hupop444/trace-memory-pebble-hackathon/TRACE-morphology-index-20260829.md

# TRACE Morphology Exploration - 2026-08-29

本轮目标不是继续给普通团子换轮廓，而是寻找一个能同时表达“触碰、留下、稍后讲述”的 TRACE 母形。所有方案均按两种尺寸考虑：包挂约 86 x 66 x 34 mm（普通 ESP32-S3），工牌约 74 x 46 x 21 mm（S3 Mini）。

## 评分标准

- 记忆点：远看轮廓和近看细节是否都能被记住。
- TRACE 契合：按压动作是否与造型变化、灯光反馈和“留下痕迹”形成同一个叙事。
- 半天制作：现有海绵 + 短毛绒包覆 + 小型硬托盘能否完成。
- 可佩戴：是否抗勾挂、不过度晃动、正反侧面都成立。
- 系列扩展：普通板和 Mini 板能否保持同一性格而不是简单缩放。

| 编号 | 方向 | 记忆点 | TRACE 契合 | 半天制作 | 可佩戴 | 系列扩展 | 总分 | 判断 |
|---|---|---:|---:|---:|---:|---:|---:|---|
| A | After-Squeeze Peanut | 3 | 4 | 5 | 4 | 5 | 21 | 结构可靠，但仍偏普通花生 |
| B | Broken Arch | 5 | 4 | 4 | 4 | 4 | 21 | 藏脸有趣，拱形仍需避免常见联想 |
| C | Pocket Fold | 4 | 5 | 5 | 5 | 5 | 24 | 互动清楚；后续需降低襁褓感 |
| D | Odd Stack | 3 | 3 | 5 | 4 | 5 | 20 | 易做，但仍像通用双层团子 |
| E | Kinked Comma | 5 | 4 | 5 | 5 | 5 | 24 | 年轻、利落、好佩戴，缺口可做按压区 |
| F | Loose Soft Knot | 5 | 5 | 2 | 3 | 3 | 18 | 雕塑感强，但裁片、内托和量产风险高 |
| G | Offset Split Seed | 4 | 5 | 4 | 4 | 5 | 22 | 互动优秀，但存在不必要的生物形态歧义 |
| H | TRACE Pucker | 5 | 5 | 5 | 5 | 5 | 25 | 最完整：缝线既是识别符号也是反馈通道 |
| I | Thumbprint Memory Dent | 5 | 5 | 5 | 5 | 5 | 25 | 最属于 TRACE：一次触碰直接成为形态记忆 |
| J | Soft Sidecar | 5 | 5 | 4 | 3 | 4 | 21 | 携带动作鲜明；桥位需做抗撕裂，颜色需降饱和 |
| K | Folded Soft Ribbon | 5 | 5 | 2 | 3 | 3 | 18 | 视觉强，但半天样机和藏板难度偏高 |
| L | Lazy Splash | 5 | 4 | 3 | 4 | 4 | 20 | 最活泼的风格外卡，可提取长弯瓣而不整套照搬 |

## 第一梯队

1. **I - Thumbprint Memory Dent**：建议作为 TRACE 的核心交互母题。按下去不是按一个按钮，而是把一个瞬间留在柔软表面。
2. **H - TRACE Pucker**：建议作为品牌视觉母题。斜向褶线可以跨包挂、工牌、腕带与桌面底座持续出现。
3. **E - Kinked Comma**：建议作为年轻活力的轮廓母题，解决 H/I 可能过于安静的问题。
4. **C - Pocket Fold**：建议保留“揭开/藏起”机制，但调整比例，避免像婴儿襁褓。
5. **L - Lazy Splash**：作为活力外卡，只提取一条长弯瓣和前折按压瓣。

## 下一轮组合原则

最有冠军潜力的方向不是直接选一张照做，而是：`I 的触碰凹痕 + H 的 TRACE 褶线 + E 的弯折轮廓`。组合时仍只保留一个主动作，避免三种特点堆在一起。

建议做三张最终收敛图：

1. `I + E`：弯折体内嵌拇指凹痕，最年轻、最直接。
2. `H + I`：褶线在凹痕处终止并亮起，最像完整品牌语言。
3. `E + L`：弯折缺口配一个长软瓣，最活泼、最适合包挂。
