hupop444/trace-memory-pebble-hackathon/electronics/TRACE_ESP32S3_SensorHub/renders/TRACE_ESP32S3_SensorHub_Schematic.png

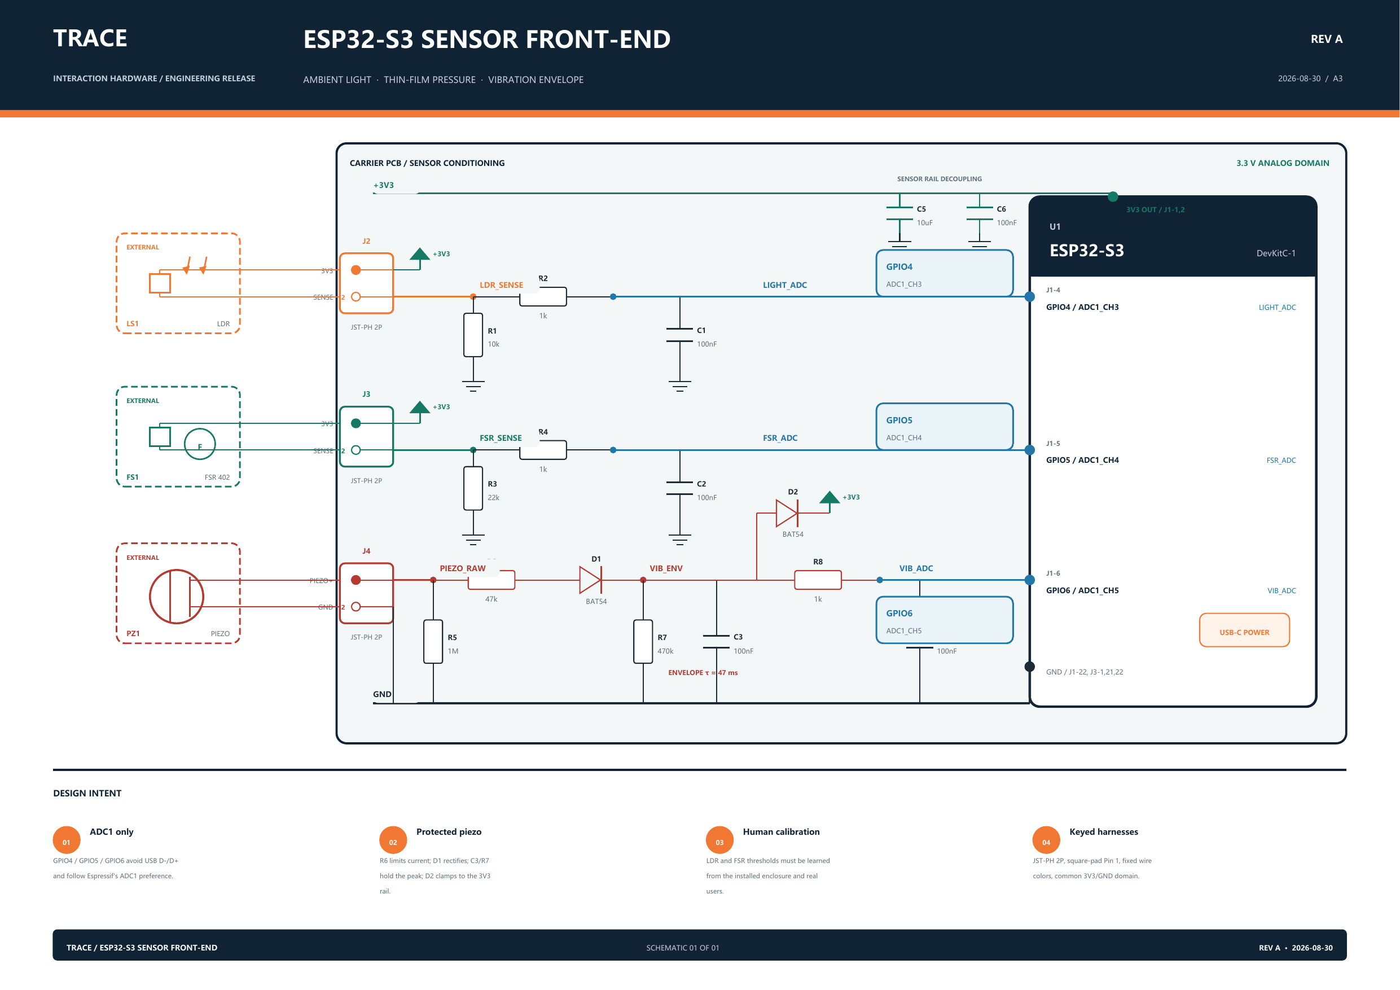
electronics/TRACE_ESP32S3_SensorHub/renders/TRACE_ESP32S3_SensorHub_Schematic.png
