hupop444/trace-memory-pebble-hackathon/exports/TRACE_bag_esp32_exploded.png

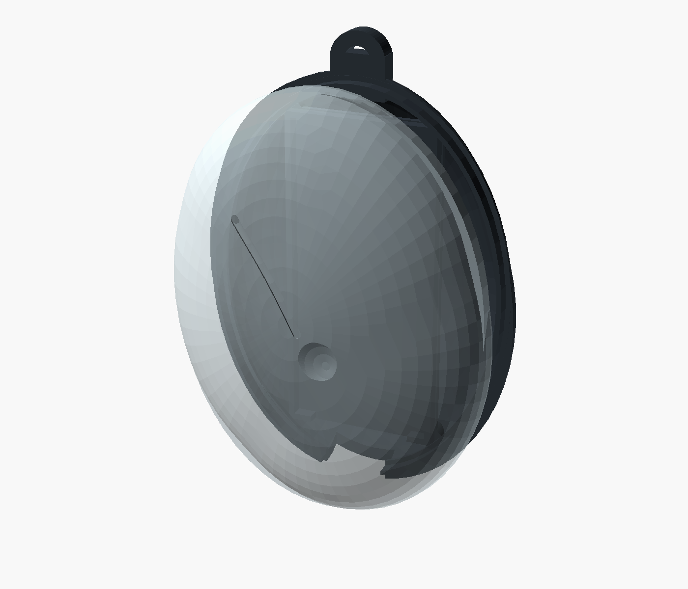
exports/TRACE_bag_esp32_exploded.png
