hupop444/trace-memory-pebble-hackathon/exports/TRACE_bag_esp32_preview.png

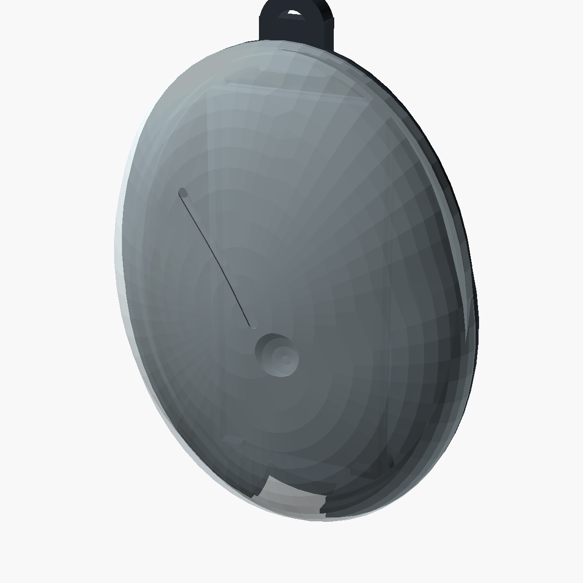
exports/TRACE_bag_esp32_preview.png
