hupop444/trace-memory-pebble-hackathon/exports/TRACE_bag_esp32_preview_locked.png

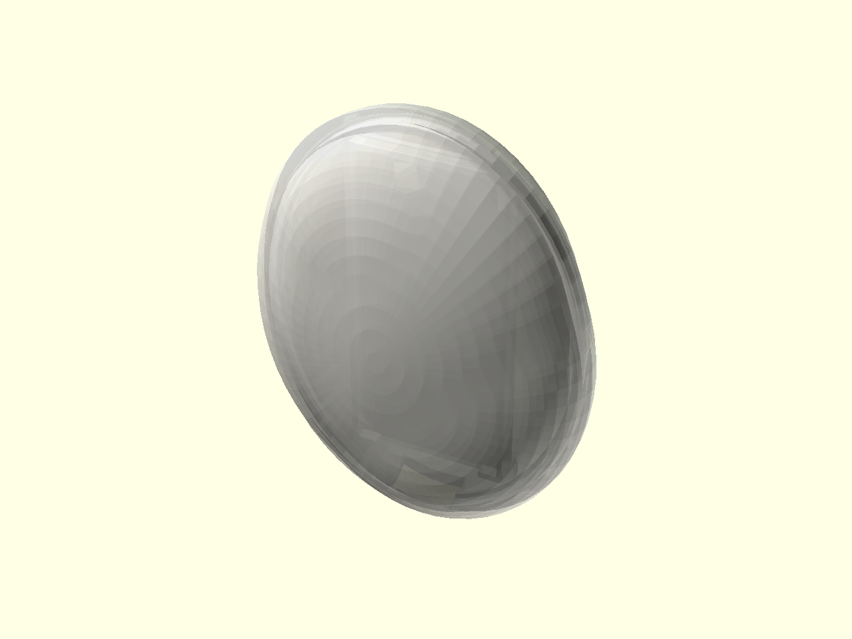
exports/TRACE_bag_esp32_preview_locked.png
