hupop444/trace-memory-pebble-hackathon/hardware/enclosure/output/trace_enclosure_preview.png

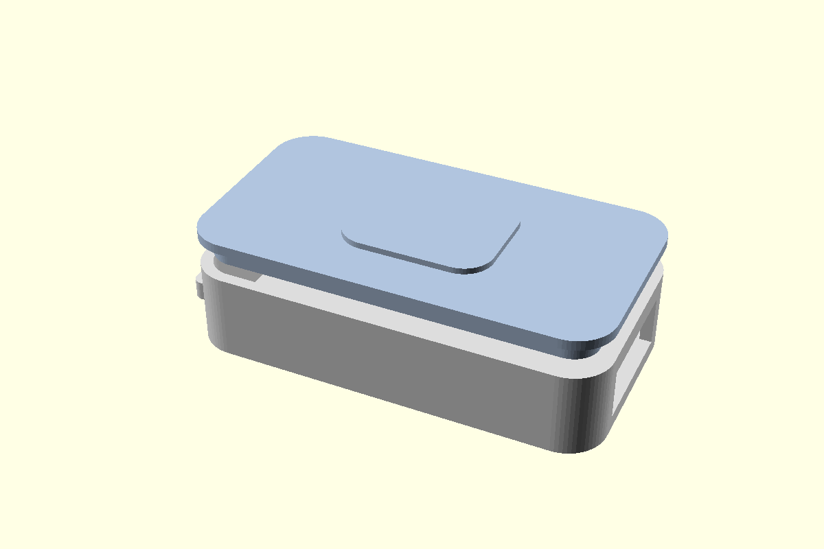
hardware/enclosure/output/trace_enclosure_preview.png
