hupop444/trace-memory-pebble-hackathon/renders/AIGC_campaign_20260829/TRACE_KV03_Family_16x9.png

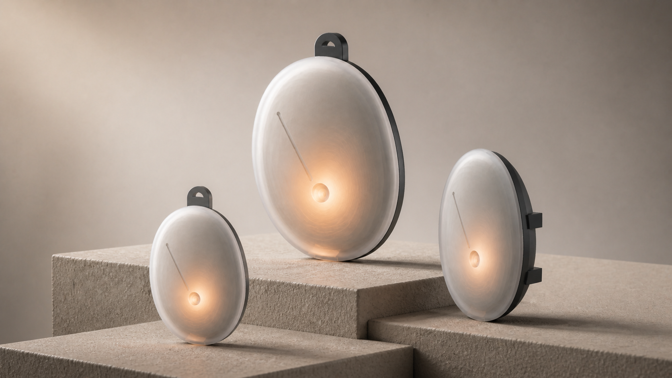
renders/AIGC_campaign_20260829/TRACE_KV03_Family_16x9.png
