hupop444/trace-memory-pebble-hackathon/renders/AIGC_campaign_20260829/TRACE_KV04_Garment_9x16.png

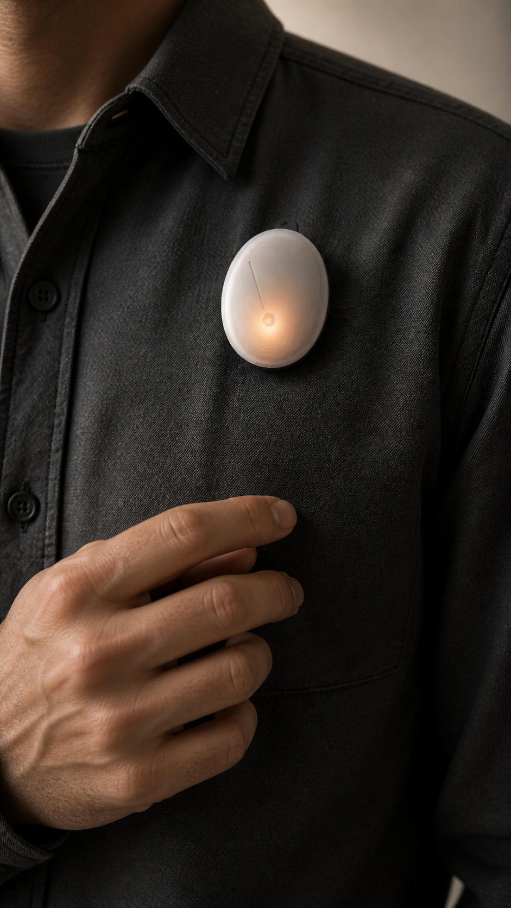
renders/AIGC_campaign_20260829/TRACE_KV04_Garment_9x16.png
