hupop444/trace-memory-pebble-hackathon/renders/AIGC_campaign_20260829/TRACE_KV05_Macro_239x1.png

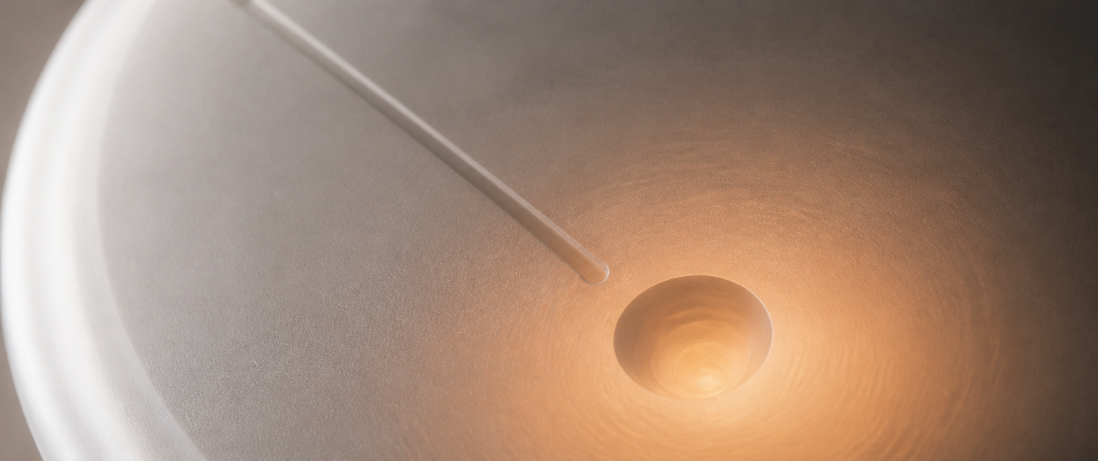
renders/AIGC_campaign_20260829/TRACE_KV05_Macro_239x1.png
