hupop444/trace-memory-pebble-hackathon/renders/AIGC_campaign_20260829_softshell_v2/TRACE_V2_KV02_SoftShell_HandPress_16x9.png

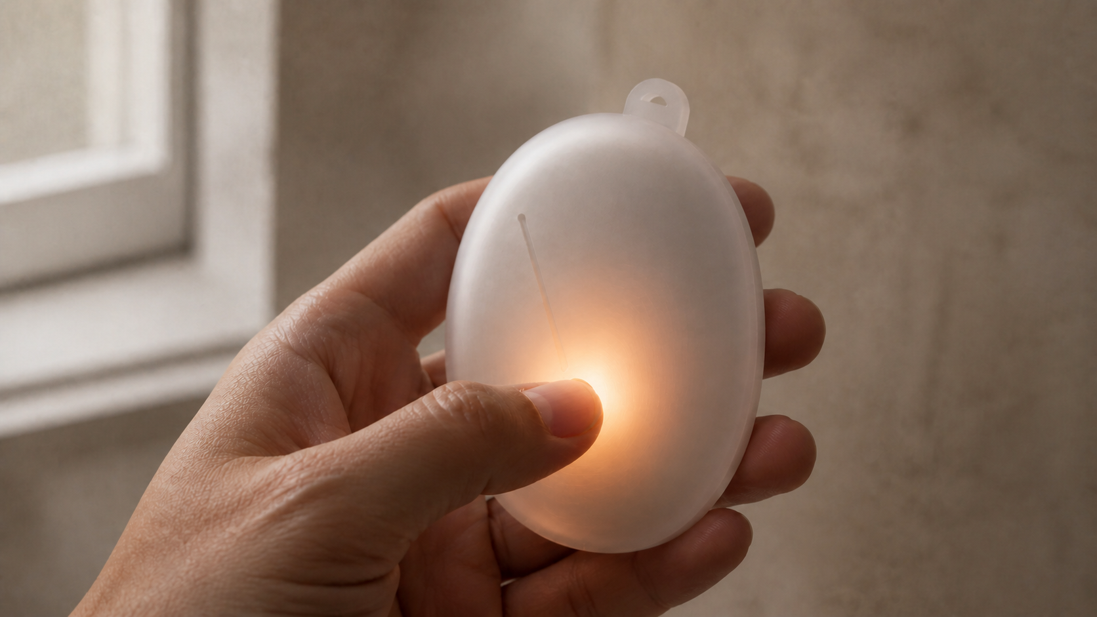
renders/AIGC_campaign_20260829_softshell_v2/TRACE_V2_KV02_SoftShell_HandPress_16x9.png
