hupop444/trace-memory-pebble-hackathon/renders/TRACE_film_locked_2.39_20260829/master_2048x858/TRACE_S03_BagCharm_239.png

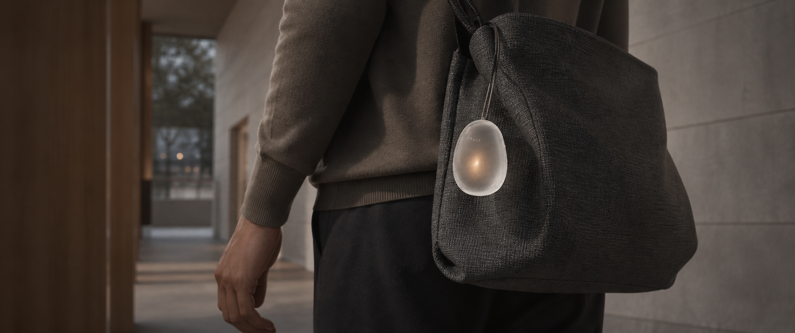
renders/TRACE_film_locked_2.39_20260829/master_2048x858/TRACE_S03_BagCharm_239.png
