hupop444/trace-memory-pebble-hackathon/renders/TRACE_film_locked_2.39_20260829/TRACE_8shot_contactsheet_2048x1716.png

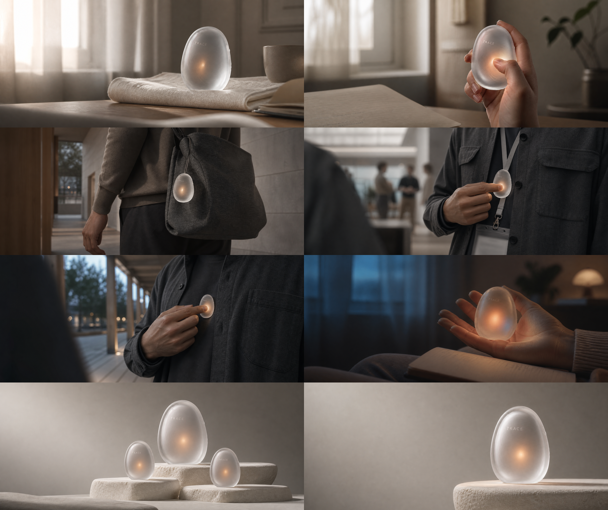
renders/TRACE_film_locked_2.39_20260829/TRACE_8shot_contactsheet_2048x1716.png
