hupop444/trace-memory-pebble-hackathon/exports/TRACE_clip_mini_front.stl

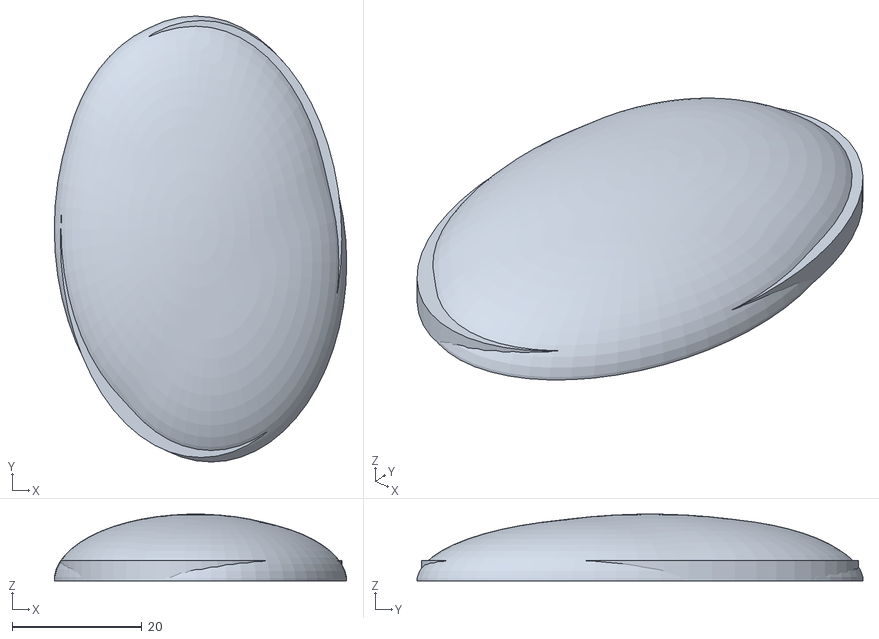
[picture p25: CAD file, 2026-08-29]
exports/TRACE_clip_mini_front.stl
45.1 x 68.8 x 10.3
