hupop444/trace-memory-pebble-hackathon/hardware/enclosure/output/trace_base.stl

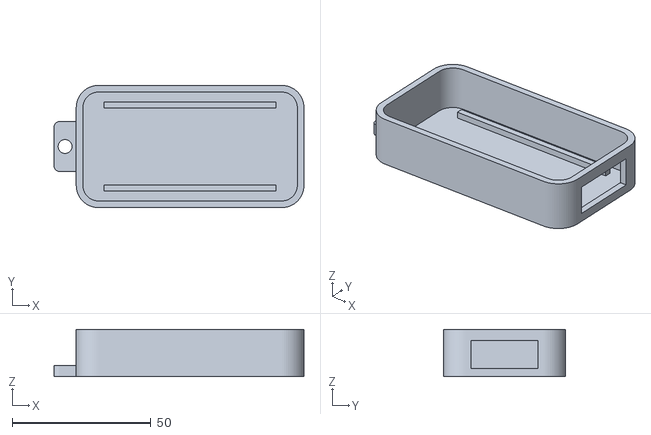
[picture p26: CAD file, 2026-08-29]
hardware/enclosure/output/trace_base.stl
90.0 x 44.0 x 17.0
