hupop444/trace-memory-pebble-hackathon/exports/TRACE_clip_mini_board.stl

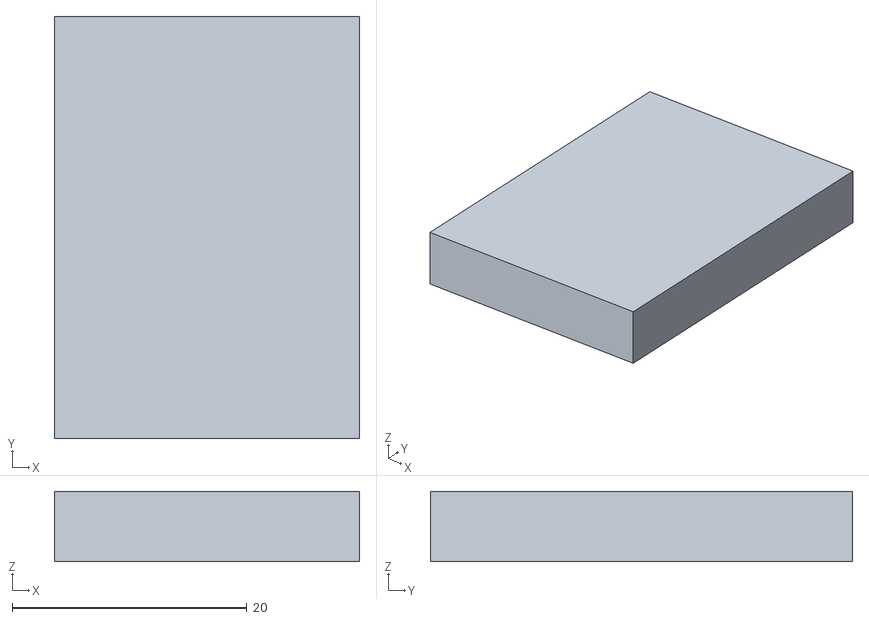
[picture p27: CAD file, 2026-08-29]
exports/TRACE_clip_mini_board.stl
26.0 x 36.0 x 6.00
