hupop444/trace-memory-pebble-hackathon/hardware/enclosure/output/trace_pressure_lid.stl

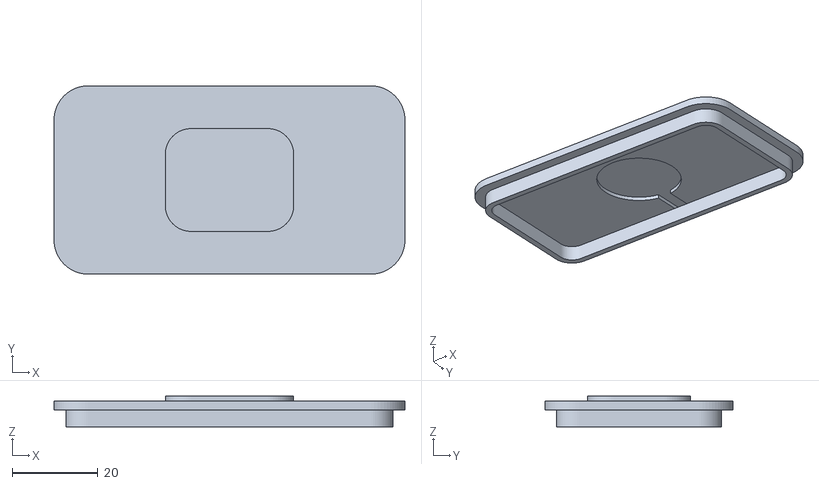
[picture p28: CAD file, 2026-08-29]
hardware/enclosure/output/trace_pressure_lid.stl
82.0 x 44.0 x 7.20
