hupop444/trace-memory-pebble-hackathon/exports/TRACE_bag_esp32_sensor.stl

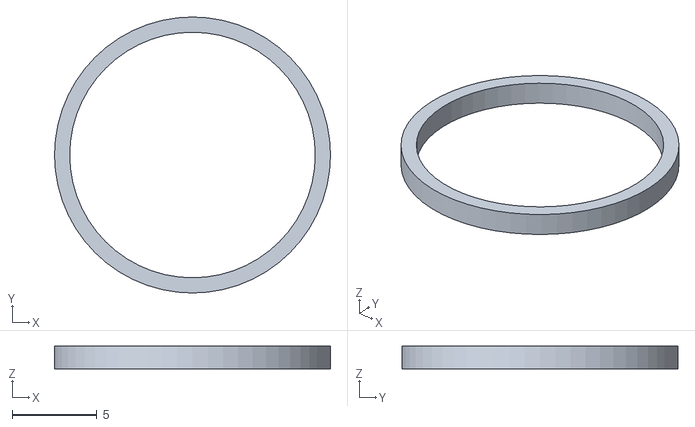
[picture p29: CAD file, 2026-08-29]
exports/TRACE_bag_esp32_sensor.stl
16.3 x 16.3 x 1.35
