hupop444/trace-memory-pebble-hackathon/exports/TRACE_badge_mini_front.stl

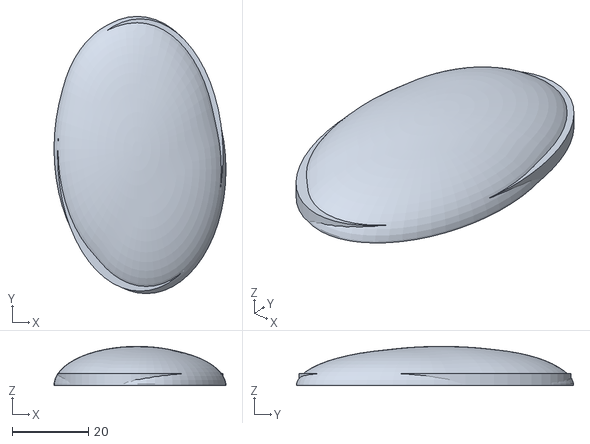
[picture p30: CAD file, 2026-08-29]
exports/TRACE_badge_mini_front.stl
45.1 x 72.7 x 10.3
