hupop444/trace-memory-pebble-hackathon/exports/TRACE_clip_mini_sensor.stl

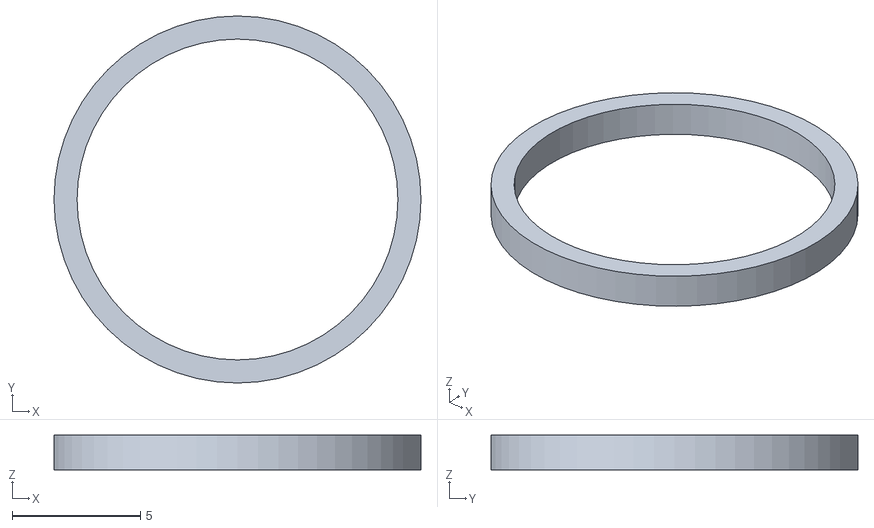
[picture p31: CAD file, 2026-08-29]
exports/TRACE_clip_mini_sensor.stl
14.3 x 14.3 x 1.35
