hupop444/trace-memory-pebble-hackathon/exports/TRACE_bag_esp32_board.stl

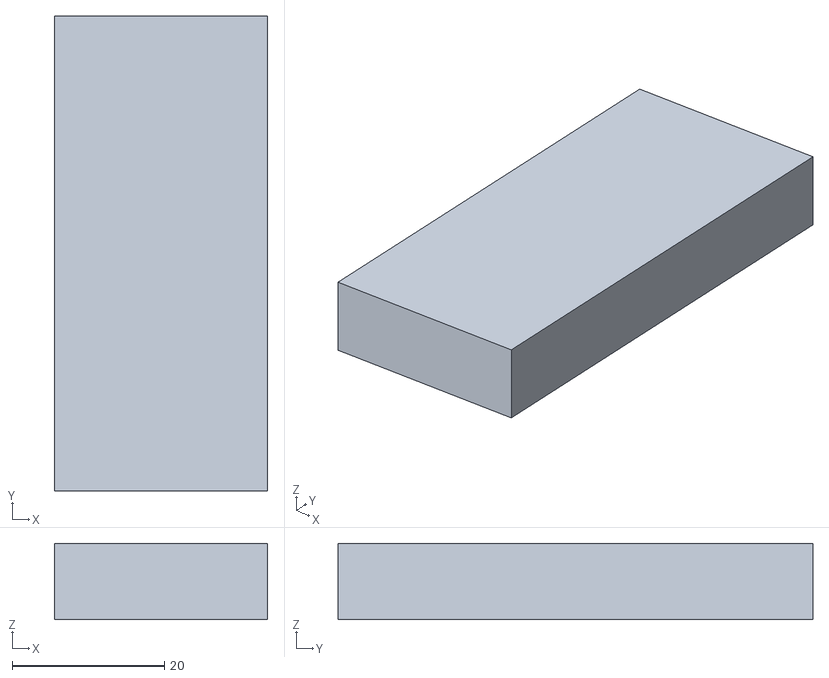
[picture p32: CAD file, 2026-08-29]
exports/TRACE_bag_esp32_board.stl
28.0 x 62.4 x 10.0
