hupop444/trace-memory-pebble-hackathon/exports/TRACE_badge_mini_back.stl

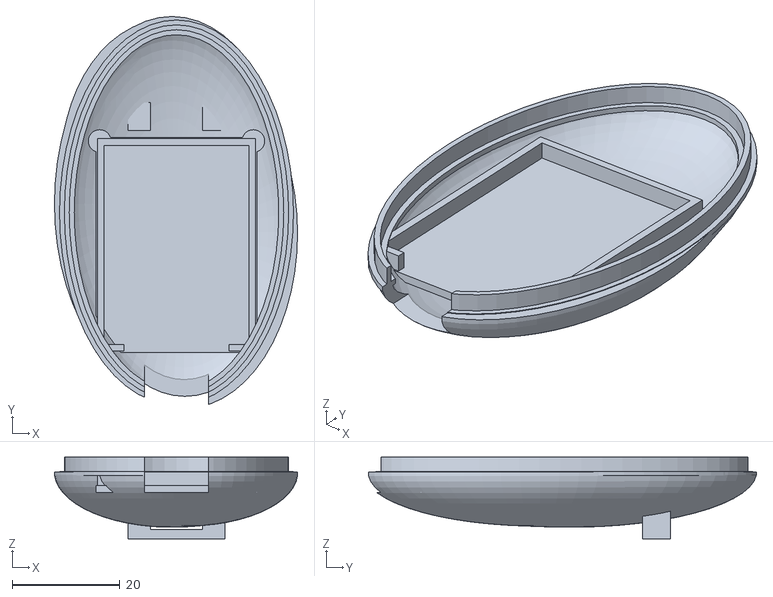
[picture p33: CAD file, 2026-08-29]
exports/TRACE_badge_mini_back.stl
45.1 x 72.0 x 15.2
