hupop444/trace-memory-pebble-hackathon/exports/TRACE_bag_esp32_front.stl

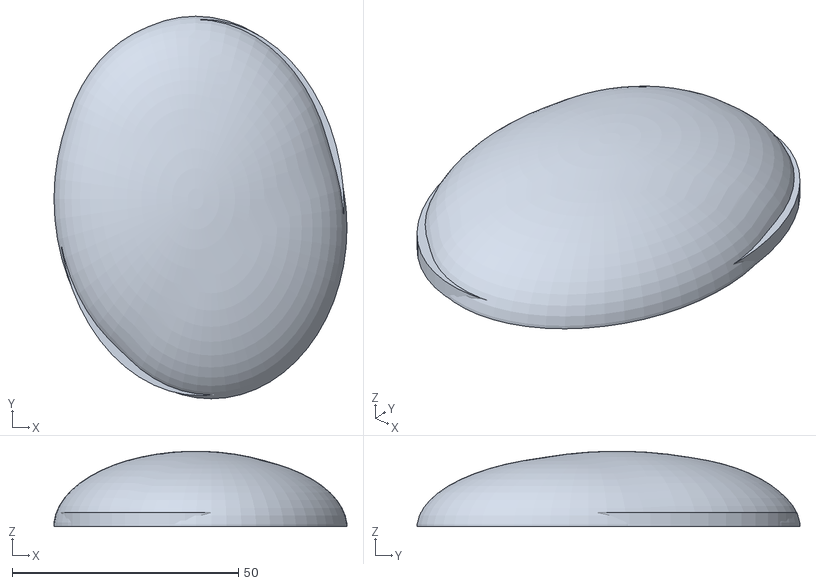
[picture p34: CAD file, 2026-08-29]
exports/TRACE_bag_esp32_front.stl
64.7 x 84.5 x 16.6
