hupop444/trace-memory-pebble-hackathon/exports/TRACE_clip_mini_back.stl

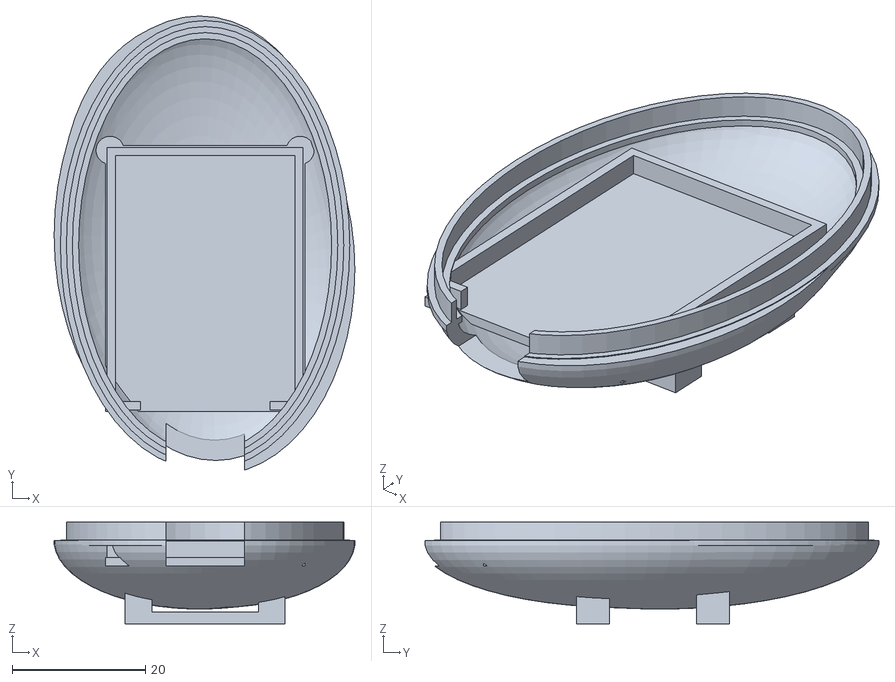
[picture p35: CAD file, 2026-08-29]
exports/TRACE_clip_mini_back.stl
45.1 x 68.1 x 15.2
