hupop444/trace-memory-pebble-hackathon/exports/TRACE_badge_mini_sensor.stl

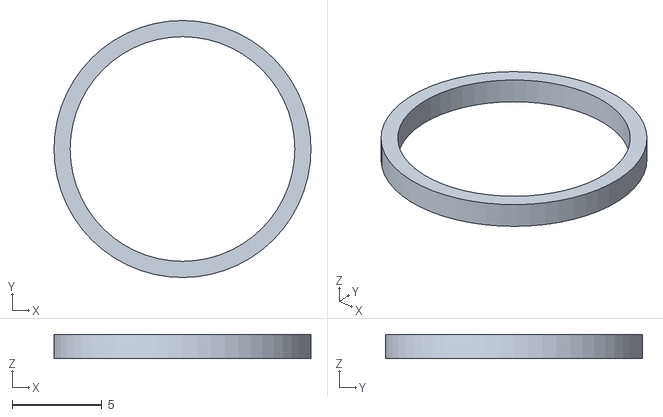
[picture p36: CAD file, 2026-08-29]
exports/TRACE_badge_mini_sensor.stl
14.3 x 14.3 x 1.35
