hupop444/trace-memory-pebble-hackathon/exports/TRACE_bag_esp32_back.stl

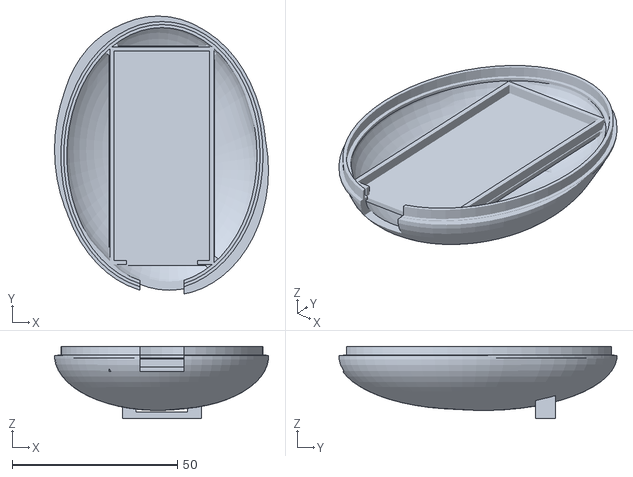
[picture p37: CAD file, 2026-08-29]
exports/TRACE_bag_esp32_back.stl
64.7 x 84.0 x 21.9
