hupop444/trace-memory-pebble-hackathon/(list of files, cad)

Other CAD files:
exports/TRACE_badge_mini_board.stl
