hupop444/trace-memory-pebble-hackathon/cad/README_PRINT_CN.md

# TRACE 鹅卵石外壳：首轮工程打印说明

本套模型是可制造的参数化基线，共三款：

| 型号 | 外形目标 | 默认板卡包络 | 挂载方式 | 推荐用途 |
|---|---:|---:|---|---|
| `bag_esp32` | 86 × 66 × 34 mm | 62.4 × 28.0 × 10.0 mm | 背面隐藏式 24 mm 桥 | 包挂、手握主机 |
| `badge_mini` | 74 × 46 × 21 mm | 36.0 × 26.0 × 6.0 mm | 背面隐藏式 18 mm 桥 | 工牌、胸前吊挂 |
| `clip_mini` | 70 × 46 × 21 mm | 36.0 × 26.0 × 6.0 mm | 背部双穿带桥 | 衣物、安全别针、扎带、魔术贴 |

默认 `visual_style="reference_locked"` 与锁定效果图一致：正面为连续、光滑、轻微不对称的柔性鹅卵石，没有斜褶线、圆形凹孔、黑边或外露挂环。大版与两款 Mini 共享同一识别基因，挂载功能全部移至背面隐藏区。需要复现早期凹痕概念时，可显式设置 `visual_style="legacy_trace"`，但该模式不用于当前宣传片与正式展示。

## 打印前必须量取的 8 个值

开发板名称不是可靠的机械标准。用卡尺量取实物后，修改 `TRACE_pebble_parametric.scad` 顶部对应参数：

1. PCB 长度 `board_length`
2. PCB 最大宽度 `board_width`
3. 从 PCB 底面到最高元件的总高 `board_height`
4. USB 插座最大宽度 `usb_width`
5. USB 插座最大高度 `usb_height`
6. USB 中心相对壳体中分面的 Z 坐标 `usb_z`
7. 压力传感器圆片直径 `pressure_sensor_diameter`
8. 打印机 XY 配合补偿；首轮默认单边 `board_clearance=0.45`、合口径向 `tongue_clearance=0.28`

默认大板仓按约 62.4 × 28 mm 的普通 ESP32-S3 开发板包络预留；默认 Mini 板仓按 36 × 26 mm 的宽容包络预留，可覆盖多类 S3 Mini/SuperMini。若实物是 XIAO ESP32S3 等更小板卡，应缩小板仓或增加可拆垫片，不应依靠大量热熔胶定位。

板卡机械资料优先使用原厂文件：Espressif 为 ESP32-S3-DevKitC-1 v1.1 提供[尺寸 PDF](https://dl.espressif.com/dl/schematics/esp_idf/DXF_ESP32-S3-DevKitC-1_V1.1_20220429.pdf)与[尺寸 DXF](https://dl.espressif.com/dl/schematics/esp_idf/DXF_ESP32-S3-DevKitC-1_V1.1_20220429.dxf)；Seeed 官方资料标注 XIAO ESP32S3 为 21 × 17.8 mm。最终尺寸仍以团队手中的实物和卡尺为准。

## 材料与切片

### 最终设计意图：软外皮 + 内承力骨架

- 可见外皮：2.5–3.0 mm 铂金硫化半透明硅胶，视觉/触感目标 Shore A 20–25，连续包覆正面与边缘。
- 内部：独立薄型刚性承力骨架固定 PCB、电池、振动电机和背面挂载件；压力区保留约 1.5–2.0 mm 局部形变空间。
- 竞赛级实物建议采用“打印模具 + 浇注硅胶外皮 + 独立打印内骨架”，而不是要求单一 FDM 材料同时承担柔软触感、光学扩散和挂载强度。

### 黑客松快速工程样：背壳（结构件）

- 材料：PETG 优先；快速外观样可用 PLA+。
- 层高：0.20 mm；外墙 4 道；顶/底 5 层；填充 20–25% Gyroid。
- 喷嘴：0.4 mm；线宽 0.42–0.46 mm。
- 摆放：合口面贴平台。背部隐藏桥按局部树状支撑。
- 强度：隐藏桥区域建议 5 道墙；受力方向必须通过实物拉力测试确认。

### 黑客松快速工程样：前壳（触摸与发光件）

- 首选：自然/半透明 TPU 95A，0.16–0.20 mm 层高、3 道墙、20–28 mm/s。
- 快速硬壳备选：自然透明 PETG；仅用于验证装配与光路，不能作为最终柔软触感证明。
- 摆放：合口面贴平台；开启 3–5 mm brim；TPU 回抽尽量低。
- 光学：RGB LED 与前壳保持 7–14 mm 混光距离，在 LED 上方增加乳白扩散片或磨砂胶带，避免形成刺眼热点。

## 结构与装配顺序

1. 先空壳试合：舌槽应能手压闭合，并可从 USB 口使用塑料撬片分离。
2. 将独立打印的 `sensor.stl` 环形座对准自然拇指落点内侧并用薄 VHB 固定，再装入压力圆片；用 0.3–0.8 mm 泡棉调整预压力。锁定版正面不再用可见凹孔指示传感器位置。
3. 将 RGB 灯置于自然拇指落点附近，将振动电机用薄 VHB 胶固定在刚性内骨架，不要直接贴在软外皮上。
4. 开发板从 USB 开口一端推入开放式托架，四周不得顶住天线区域。
5. 完成功能通电测试后合壳。展示样可在舌槽四点使用少量可移除 B-7000；工程迭代样保持干式装配。
6. 包挂版使用背面隐藏桥连接 2–4 mm 硅胶绳；工牌版使用背桥适配安全断开式颈绳；衣物版可穿 10–20 mm 松紧带、别针底座或扎带。

## 人体工学验收

- 大版单手握持时，拇指自然落点应位于压力传感有效区中心 ±8 mm；不得要求拇指极限外展。
- 胸前佩戴总成质量建议控制在 45 g 内；包挂总成建议控制在 80 g 内。
- 所有贴身边缘保持连续圆滑；USB 开口和挂环内缘去毛刺。
- 走动 10 分钟检查晃动、翻面、勾挂和敲击身体四项问题；工牌版若持续翻面，使用双点绳或加宽颈绳连接件。
- 压力动作以舒适、短行程为目标；FSR/压电阈值通过软件标定，不通过增加坚硬凸点迫使用户用力。

## 生成命令

请将 OpenSCAD 安装在系统路径或仓库外的临时工具目录，避免把大型 CAD 运行库提交进仓库：

```powershell
& '.\tools\export_trace_stls.ps1'
```

每款会导出背壳、前壳、压力传感器座和板卡禁入体四个 STL。`TRACE_pebble_parametric.scad` 是完整参数化母版，可继续在 OpenSCAD 中修改；前后壳 STL 直接用于切片，`board.stl` 只用于装配碰撞检查，不打印。

导出后运行严格网格检查：

```powershell
python '.\tools\validate_trace_stl.py'
```

报告写入 `exports/TRACE_validation_report.json`；六个主壳体必须同时满足 `watertight=true`、`components=1`、`degenerate_triangles=0`。

## 本轮刻意保留的工程边界

- USB-C 开口按通用包络建模；最终位置必须以实物板测量为准。
- 天线净空、开关、麦克风、充电电池和电源开关位置尚未从真实电子装配锁定，因此没有虚构开孔。
- 外形尺寸已经锁定为首轮人体工学打印基线；最终量产壁厚、跌落强度和皮肤接触材料需要实物测试后再收敛。
