hupop444/trace-memory-pebble-hackathon/hardware/software-integration/software-stage-verified.png

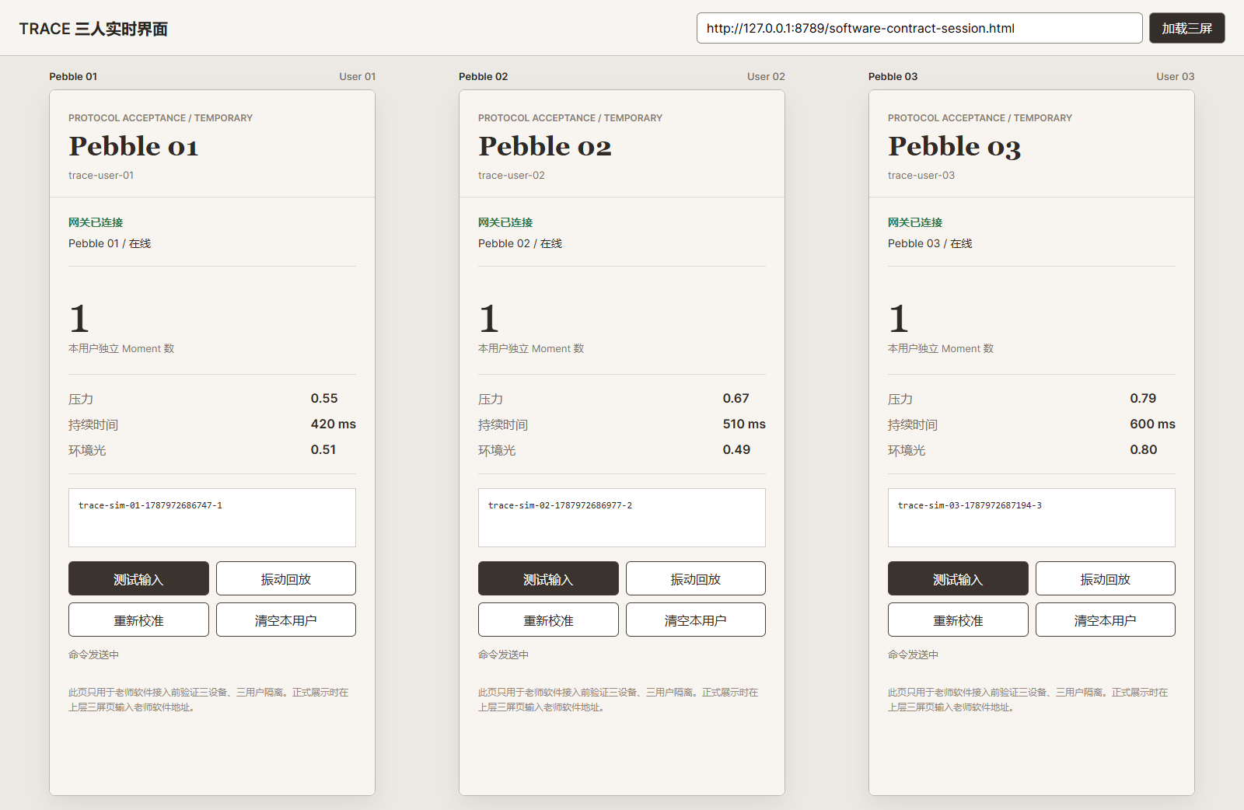
hardware/software-integration/software-stage-verified.png
