hupop444/trace-memory-pebble-hackathon/electronics/TRACE_ESP32S3_SensorHub/output/pdf/TRACE_ESP32S3_SensorHub_Schematic.pdf

# TRACE

# ESP32-S3 SENSOR FRONT-END

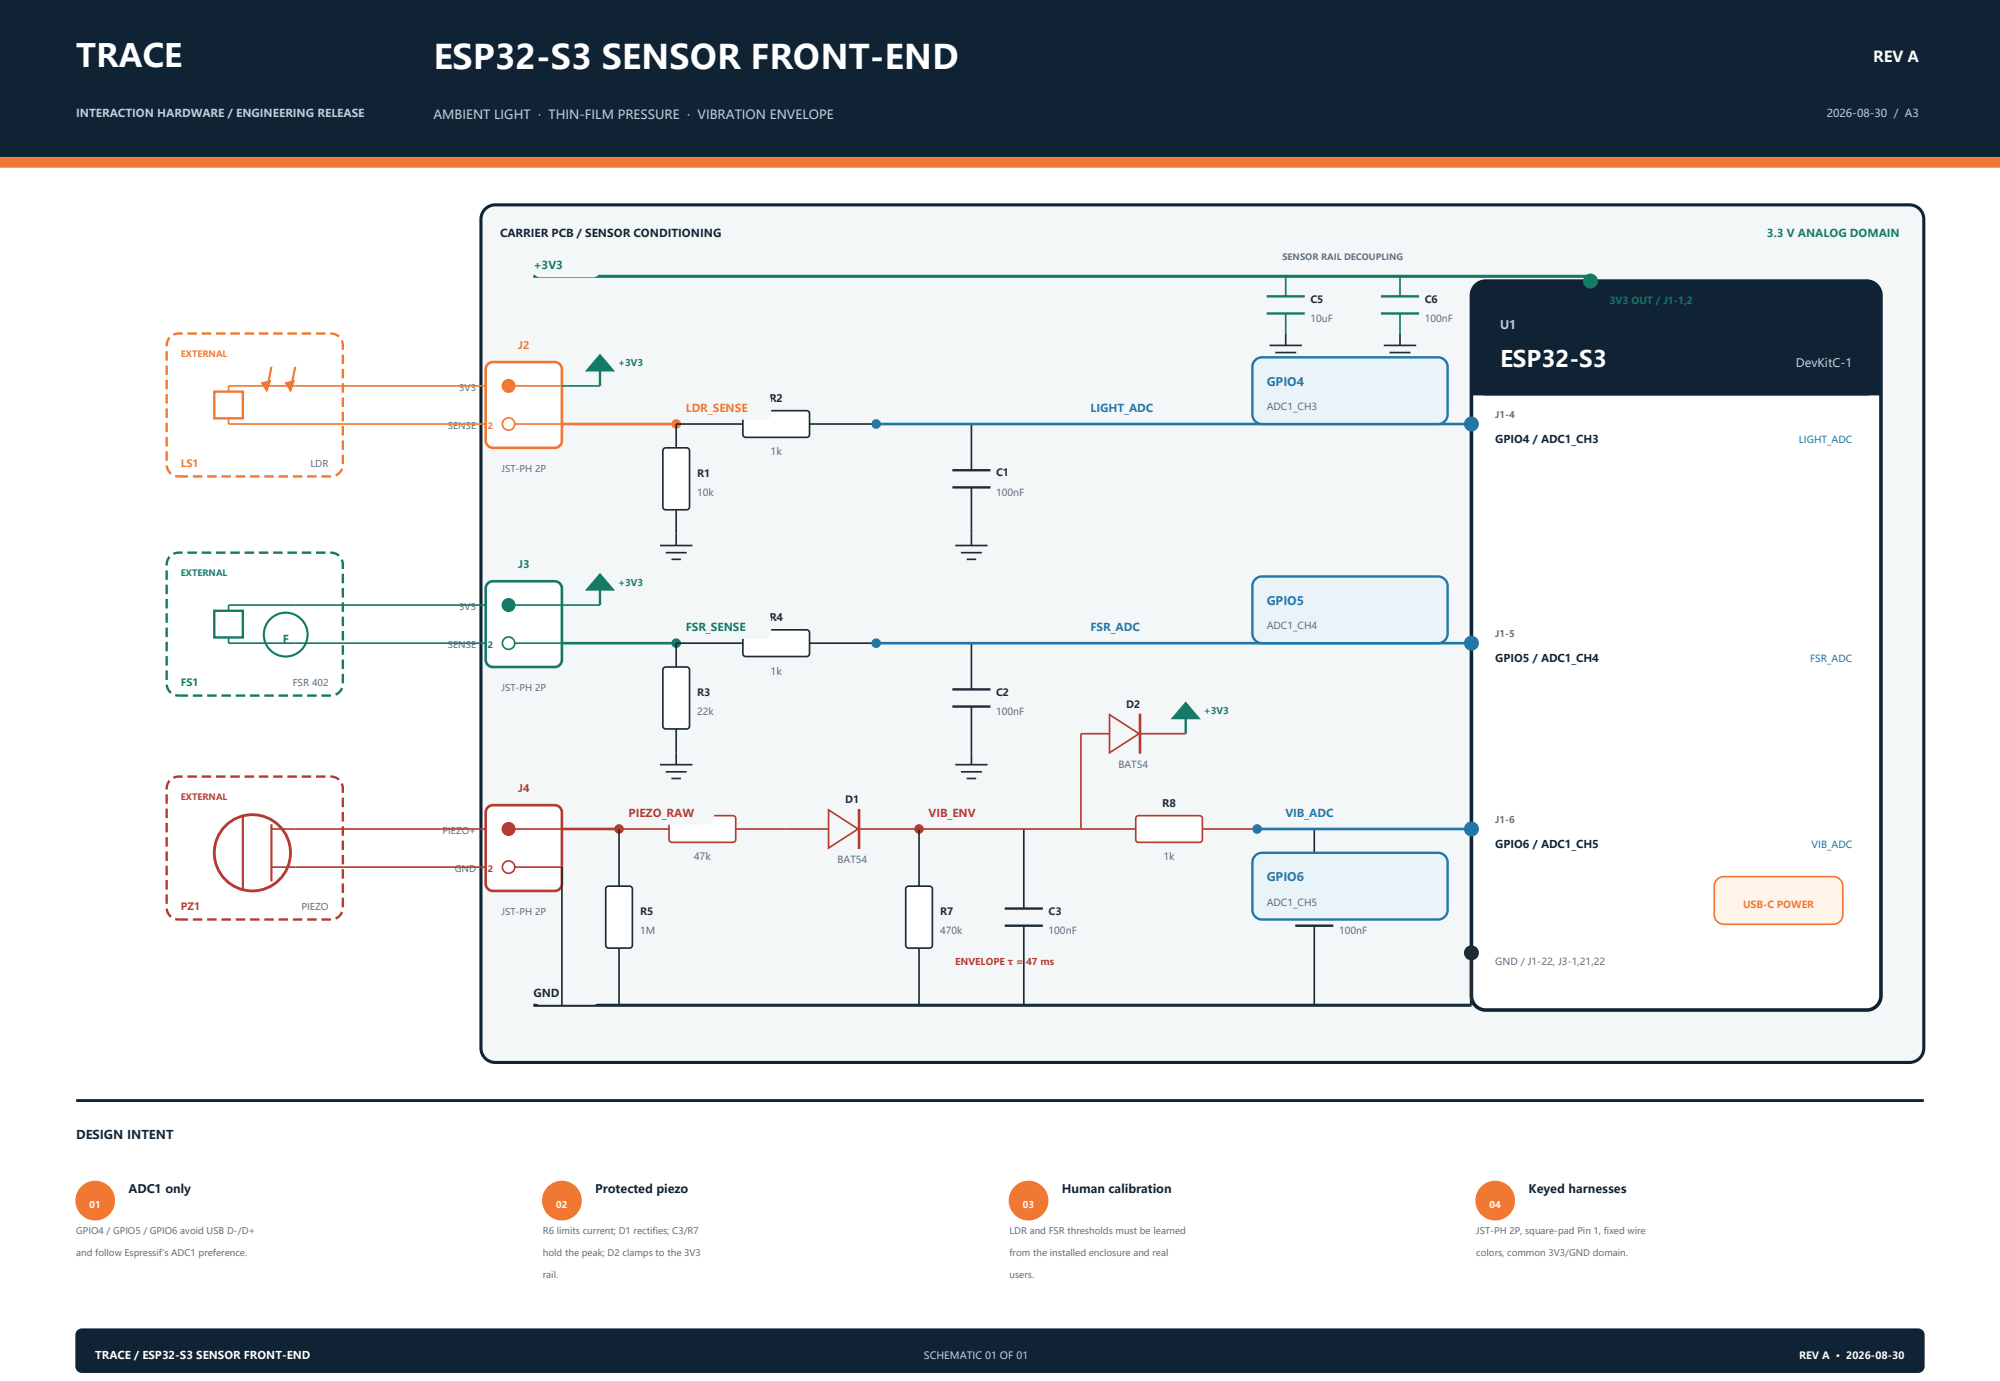
[picture p39: page 1]

INTERACTION HARDWARE / ENGINEERING RELEASE

AMBIENT LIGHT · THIN-FILM PRESSURE · VIBRATION ENVELOPE

LDR and FSR thresholds must be learned

JST-PH 2P, square-pad Pin 1, fixed wire

and follow Espressif's ADC1 preference.

hold the peak; D2 clamps to the 3V3

from the installed enclosure and real

colors, common 3V3/GND domain.
