hupop444/trace-memory-pebble-hackathon/electronics/TRACE_ESP32S3_SensorHub/TRACE_ESP32S3_SensorHub.kicad_sch

## KiCad design electronics/TRACE_ESP32S3_SensorHub/TRACE_ESP32S3_SensorHub.kicad_sch (2026-08-29)

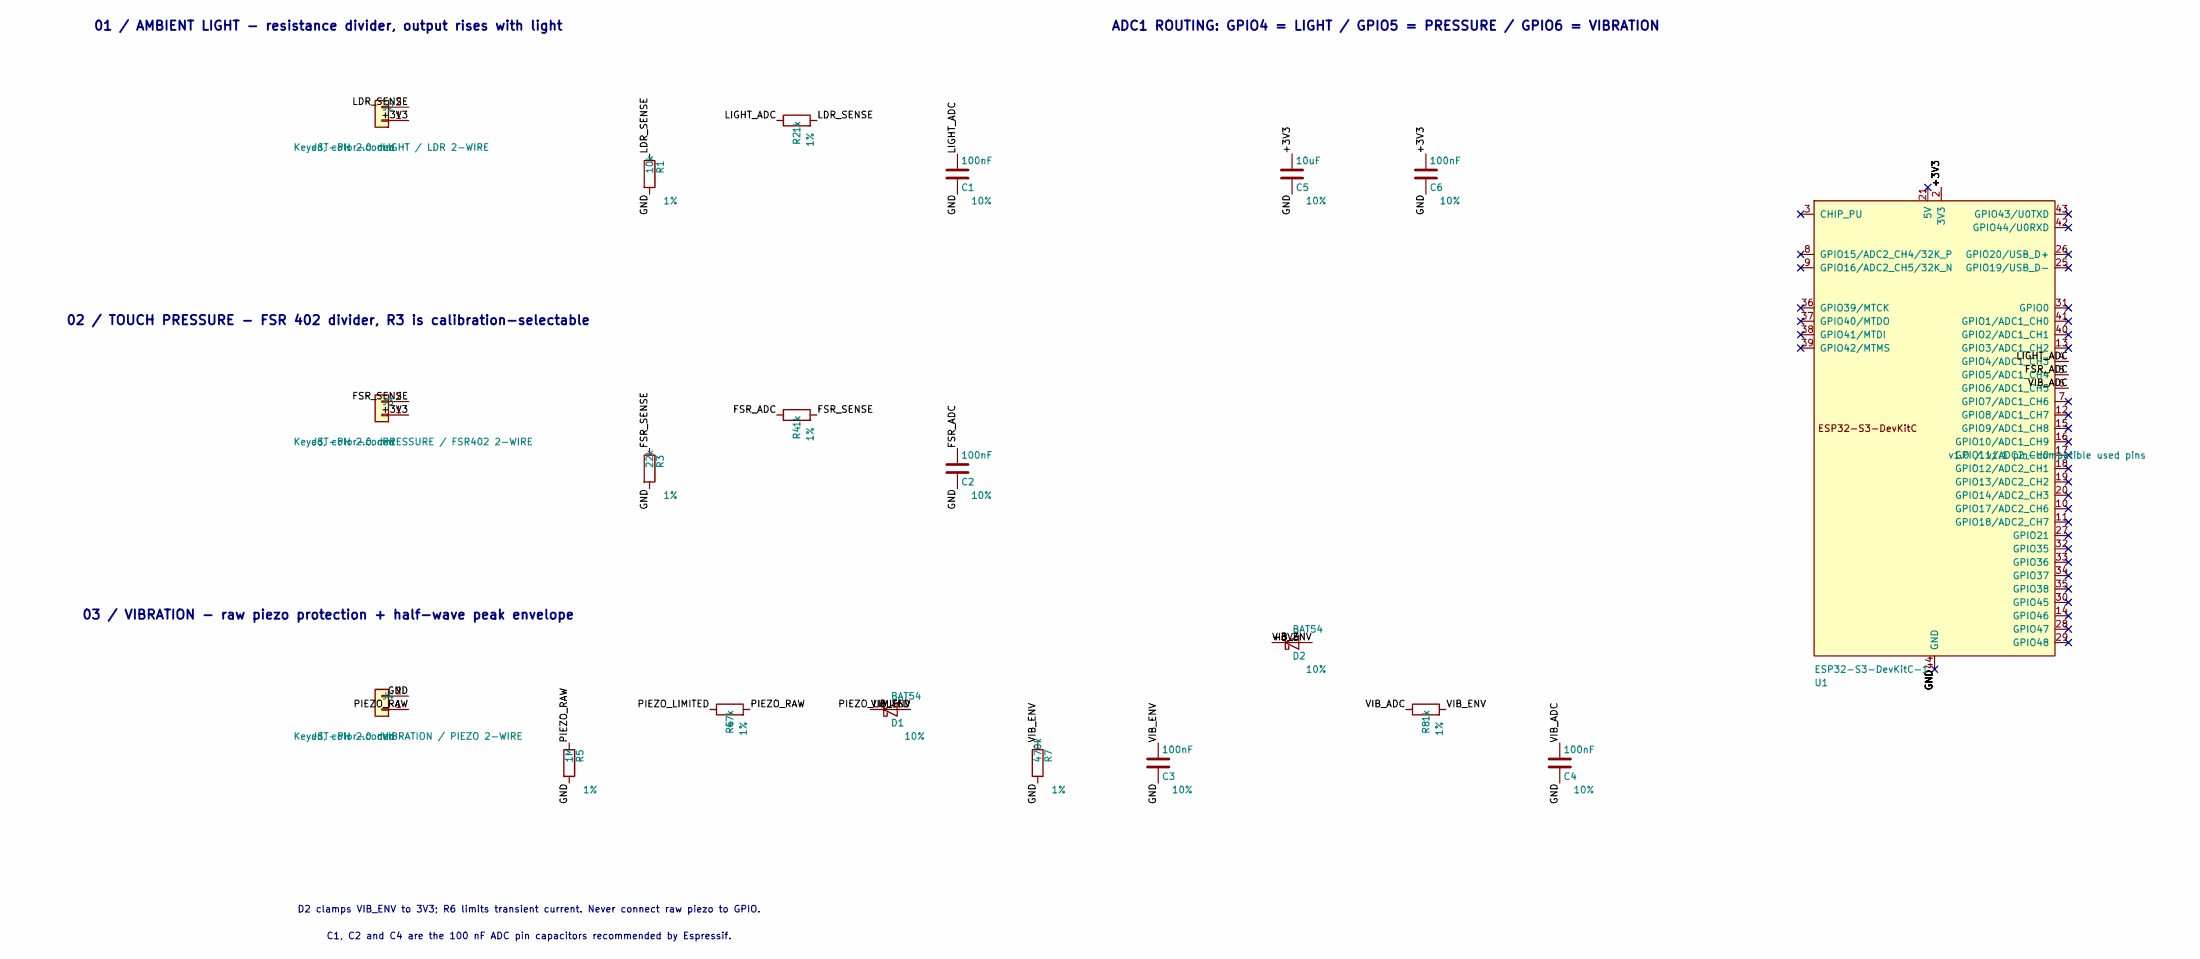
[picture p40: schematic TRACE_ESP32S3_SensorHub.kicad_sch]

Parts:
C1, C2, C3, C4, C6: 100nF; Tolerance 10%
C5: 10uF; Tolerance 10%
D1, D2: BAT54; Tolerance 10%
J2: LIGHT / LDR 2-WIRE; JST_PH_B2B-PH-K_1x02_P2.00mm_Vertical
J3: PRESSURE / FSR402 2-WIRE; JST_PH_B2B-PH-K_1x02_P2.00mm_Vertical
J4: VIBRATION / PIEZO 2-WIRE; JST_PH_B2B-PH-K_1x02_P2.00mm_Vertical
R1: 10k; Tolerance 1%
R2, R4, R8: 1k; Tolerance 1%
R3: 22k; Tolerance 1%
R5: 1M; Tolerance 1%
R6: 47k; Tolerance 1%
R7: 470k; Tolerance 1%
U1: ESP32-S3-DevKitC-1; ESP32-S3-DevKitC

Connections:
+3V3: C5.1, C6.1, D2.1 (K), J2.1, J3.1, U1.1 (3V3), U1.2 (3V3)
FSR_ADC: C2.1, R4.1, U1.5 (GPIO5/ADC1_CH4)
FSR_SENSE: J3.2, R3.1, R4.2
GND: C1.2, C2.2, C3.2, C4.2, C5.2, C6.2, J4.2, R1.2, R3.2, R5.2, R7.2, U1.22 (GND), U1.23 (GND), U1.24 (GND), U1.44 (GND)
LDR_SENSE: J2.2, R1.1, R2.2
LIGHT_ADC: C1.1, R2.1, U1.4 (GPIO4/ADC1_CH3)
PIEZO_LIMITED: D1.2 (A), R6.1
PIEZO_RAW: J4.1, R5.1, R6.2
VIB_ADC: C4.1, R8.1, U1.6 (GPIO6/ADC1_CH5)
VIB_ENV: C3.1, D1.1 (K), D2.2 (A), R7.1, R8.2

Notes on the sheet:
01 / AMBIENT LIGHT - resistance divider, output rises with light
02 / TOUCH PRESSURE - FSR 402 divider, R3 is calibration-selectable
03 / VIBRATION - raw piezo protection + half-wave peak envelope
ADC1 ROUTING: GPIO4 = LIGHT / GPIO5 = PRESSURE / GPIO6 = VIBRATION
D2 clamps VIB_ENV to 3V3; R6 limits transient current. Never connect raw piezo to GPIO.
C1, C2 and C4 are the 100 nF ADC pin capacitors recommended by Espressif.
